jwb556/board1/README.txt

There are 54 SMD placements, with 26 unique parts
There are additionally (3) BOM line items that are TH and would be placed by hand

Assembly Cost Estimate
Quan	Price/Board
3	193
10	75.90
25	33.72
50	19.56
100	12.52
500	6.92
750	6.45
