jwb556/board1/bom/bom.xlsx

Id | Designator | Package | Quantity | Designation | Supplier and ref | Price | Quantity | Total
1 | ,,, | 1940-04-01 | 4 | 1940-04-01
2 | C1,C3,C5,C10,C12,C16 | C_0805_HandSoldering | 6 | 10uF | 399-8013-1-ND | 0.29 | 6 | 1.74
3 | C2,C4,C8,C9,C18 | C_0805_HandSoldering | 5 | 10u | 399-8013-1-ND | 0.29 | 5 | 1.45
4 | C6,C7 | C_0805_HandSoldering | 2 | 10n | 399-7995-1-ND | 0.24 | 2 | 0.48
5 | C11,C19,C20 | C_0805_HandSoldering | 3 | 1u | 399-1284-1-ND | 0.12 | 3 | 0.36
6 | C13,C14,C15,C17 | C_0805_HandSoldering | 4 | .1uF | 399-1167-1-ND | 0.11 | 4 | 0.44
7 | P1 | CONN_MOLEX_.1IN_2x5 | 1 | CONN_01X10 | WM9219-ND | 1.62 | 1 | 1.62
8 | R1 | R_0805_HandSoldering | 1 | 2.2k | 311-2.20KCRCT-ND | 0.1 | 1 | 0.1
9 | R2,R3 | R_0805_HandSoldering | 2 | 16k | P16.0KCCT-ND | 0.1 | 2 | 0.2
10 | R4,R5,R6,R7,R14 | R_0805_HandSoldering | 5 | 100k | P100KCDKR-ND | 0.1 | 5 | 0.5
11 | R8,R9 | R_0805_HandSoldering | 2 | 470 | 311-470ARCT-ND | 0.1 | 2 | 0.2
12 | R10,R11 | R_0805_HandSoldering | 2 | 1M | P1.00MCCT-ND | 0.1 | 2 | 0.2
13 | R12,R13 | R_0805_HandSoldering | 2 | 500 | RNCP0805FTD499RCT-ND | 0.1 | 2 | 0.2
14 | U1 | 781710002 | 1 | ConnP2 | WM4459CT-ND | 0.58 | 1 | 0.58
15 | U2 | CMA-4544PF-W | 1 | CMA-4544PF-W | 102-1721-ND | 0.96 | 1 | 0.96
16 | U3 | SOIC-8-N | 1 | MAX1659ESA | MAX1659ESA+-ND | 5.73 | 1 | 5.73
17 | U4 | SOIC-8-N | 1 | LT1881 | LT1881CS8#PBF-ND | 5.78 | 1 | 5.78
18 | U5 | SOT-23 | 1 | APE8865N-33-HF-3 | AS1360-50-TCT-ND | 1.41 | 1 | 1.41
19 | U6 | SOIC-8-N | 1 | LT1178 | LT1178S8#PBF-ND | 7.04 | 1 | 7.04
20 | U7 | ASFL1 | 1 | ASFL1-4.00MHZ-L-T | 535-9271-1-ND | 1.77 | 1 | 1.77
21 | U8 | SOT-23-6 | 1 | MAX1721 | MAX1721EUT+T-ND | 0.77 | 1 | 0.77
22 | D1,D2 | LED_0805 | 2 | LED | 160-1423-1-ND | 0.29 | 2 | 0.58
23 | W1,W2,W3,W4,W5,W6,W7,W8 | TESTPOINT-TH-KEYSTONE5118 | 8 | TEST_1P | 36-5118-ND | 0.37 | 8 | 2.96
24 | L1 | R_0805 | 1 | L_Small | 732-3433-1-ND | 0.92 | 1 | 0.92
25 | U9 | SOIC28-75 | 1 | dsPIC33EP32MC202-I | DSPIC33EP32MC202-I/SS-ND | 1.89 | 1 | 1.89
26 | C21,C22,C23,C24 | C_0805_HandSoldering | 4 | 2.2u | 399-1295-1-ND | 0.17 | 4 | 0.68
27 | U10 | 528921495 | 1 | CONNx14 | WM8835CT-ND (http://www.digikey.com/product-detail/en/molex-connector-corporation/52892-1495/52892-1495-ND/1060264) | 2.29 | 1 | 2.29
28 | R15,R16 | R_0805_HandSoldering | 2 | 12 | 311-12ARCT-ND | 0.1 | 2 | 0.2
29 | U11 | JST-SM02B-SRSS-TB | 1 | ConnP2 | 455-1802-1-ND | 0.44 | 1 | 0.44
30 | RV1 | POT-TC33X-2-103E | 1 | 10k | TC33X-103ECT-ND | 0.27 | 1 | 0.27
 |  |  |  |  |  |  | TOTAL | 41.76
) |  |  |  |  |  |  | 64
