jwb556/board1/enclosure/main_assembly.FCStd

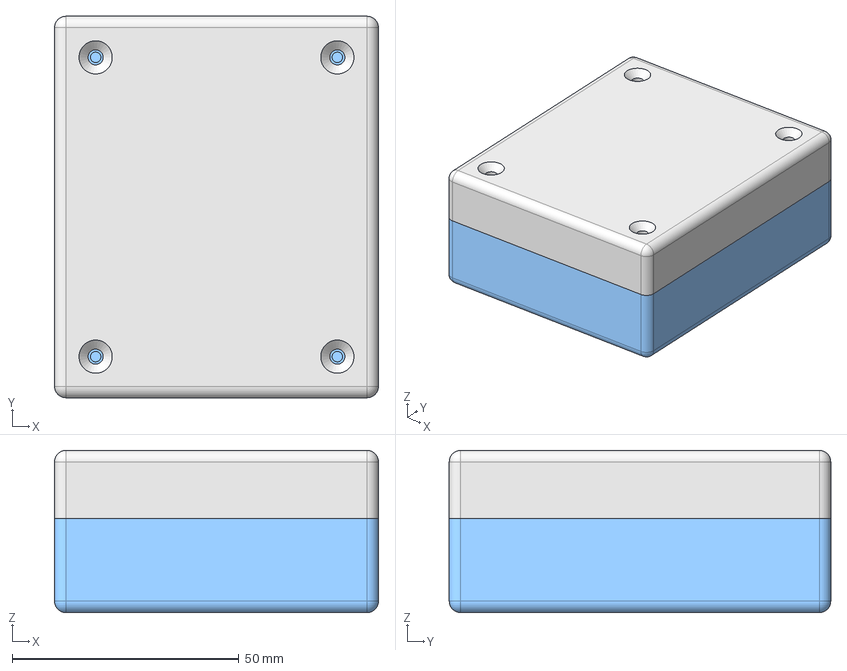
[picture p1: CAD file, 2016-06-01]
enclosure/main_assembly.FCStd
71.5 x 84.2 x 35.8 mm
