jwb556/board1/enclosure/main_bottom.FCStd

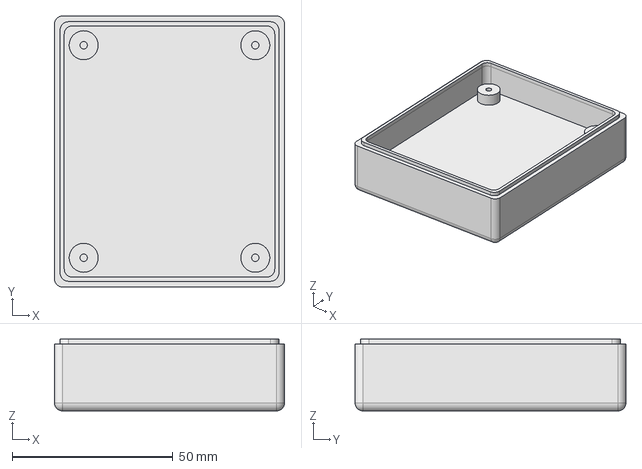
[picture p2: CAD file, 2016-06-01]
enclosure/main_bottom.FCStd
71.5 x 84.2 x 22.3 mm
