jwb556/board1/enclosure/main_top.step

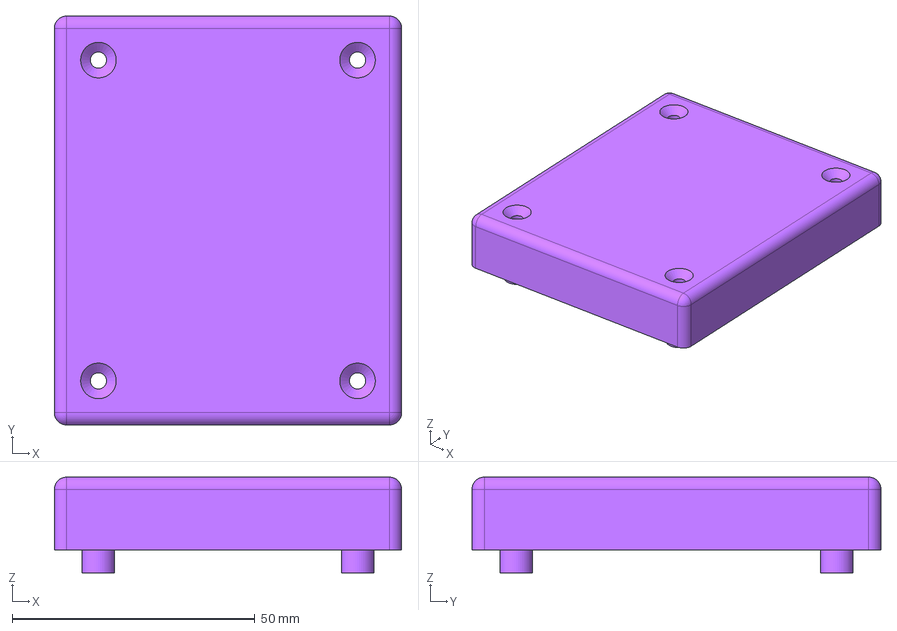
[picture p3: CAD file, 2016-06-01]
enclosure/main_top.step
71.5 x 84.2 x 19.7 mm
