jwb556/board1/enclosure/mock_board.FCStd

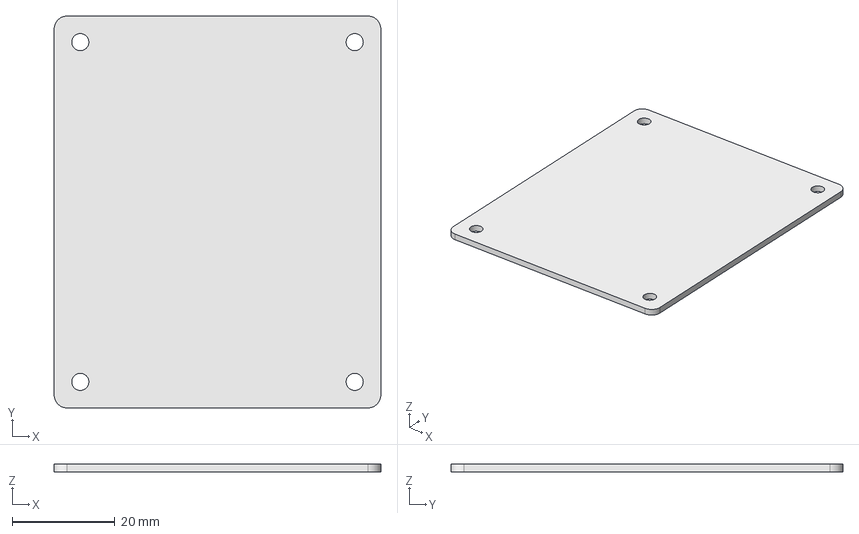
[picture p4: CAD file, 2016-06-01]
enclosure/mock_board.FCStd
63.5 x 76.2 x 1.57 mm
