jwb556/board1/jlibs/3DModels/mic.stp

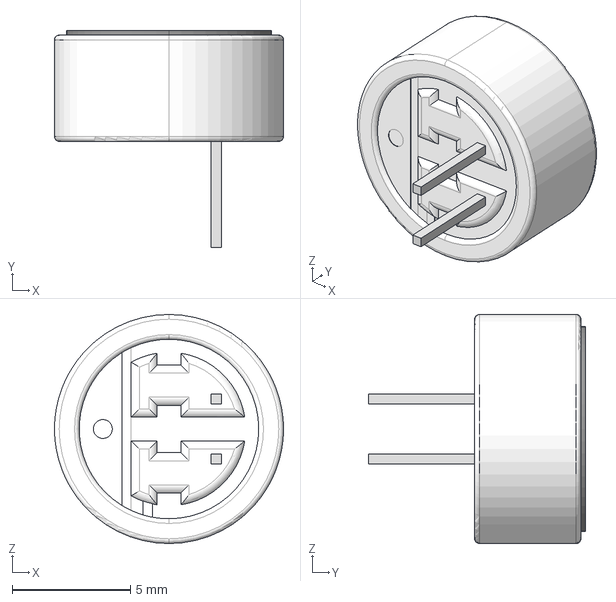
[picture p5: CAD file, 2016-06-01]
jlibs/3DModels/mic.stp
9.70 x 9.20 x 9.70 mm
