jwb556/board1/jlibs/3DModels/TC-33X-2.step

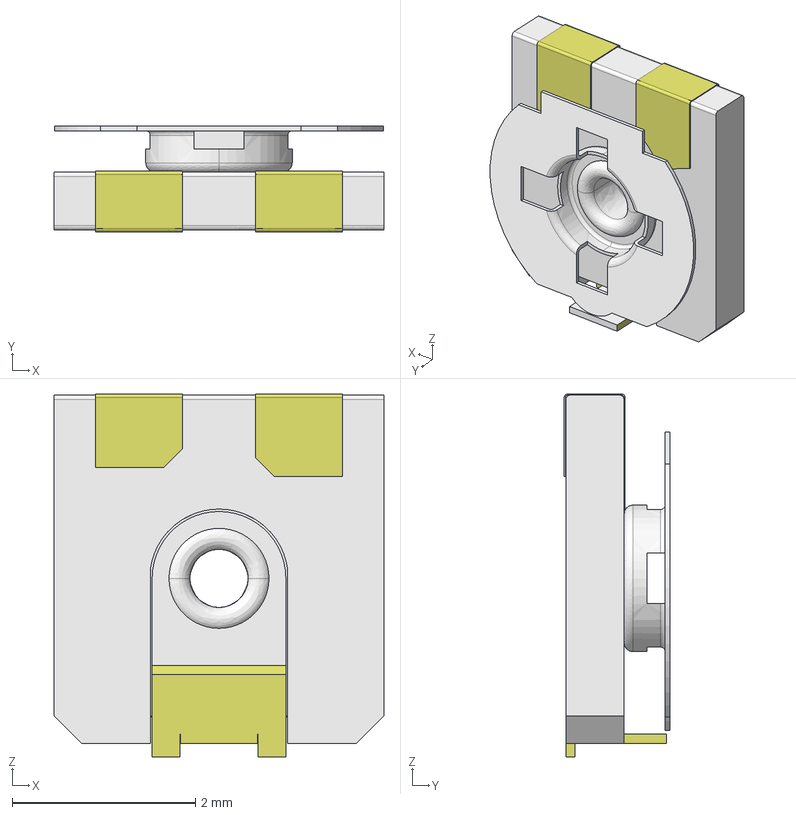
[picture p6: CAD file, 2016-06-01]
jlibs/3DModels/TC-33X-2.step
3.60 x 1.15 x 3.96 mm
