jwb556/board1/jlibs/3DModels/TP-5118.step

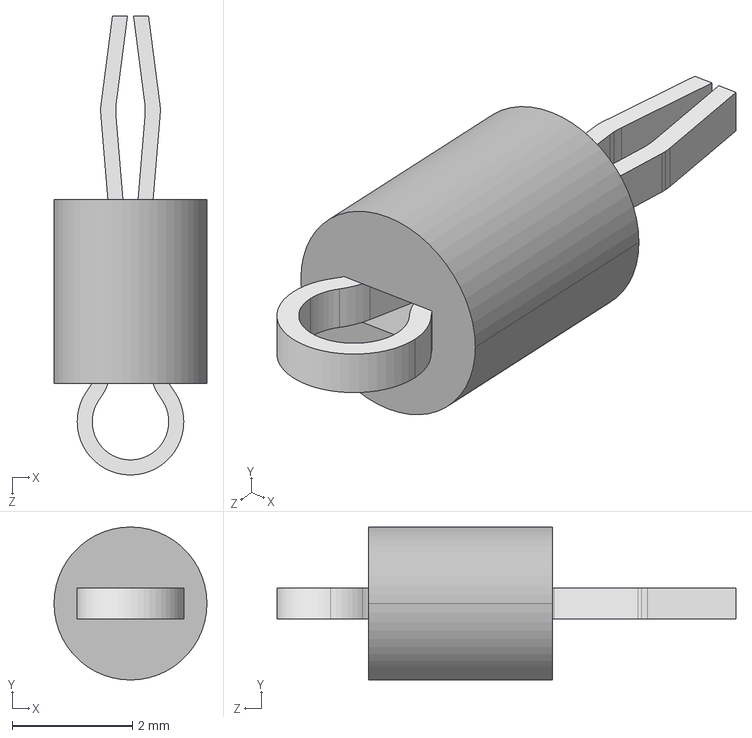
[picture p7: CAD file, 2016-06-01]
jlibs/3DModels/TP-5118.step
2.54 x 2.54 x 7.62 mm
User Library-Test Point Keystone - 5118 GREY_1
User Library-Test Point Keystone - 5118 GREY_2
