jwb556/board1/enclosure/enclosuretop.stl

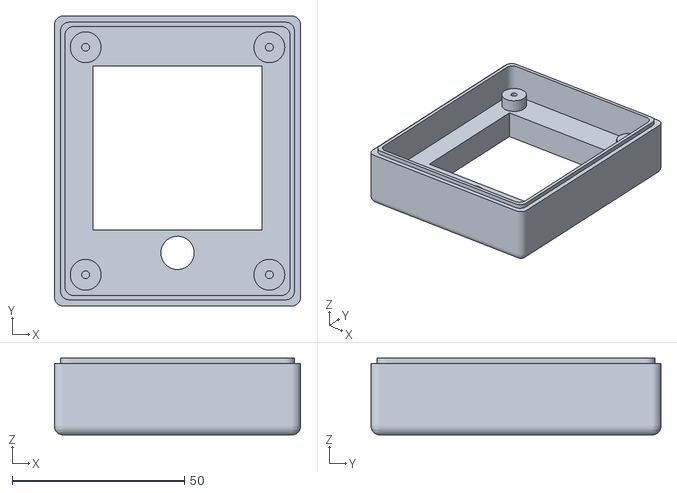
[picture p8: CAD file, 2016-06-01]
enclosure/enclosuretop.stl
71.5 x 84.2 x 22.3
