jwb556/board1/enclosure/pcb_mic.step

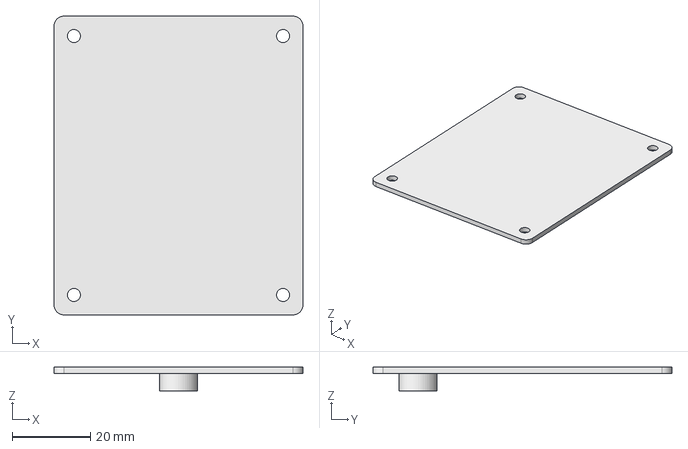
[picture p9: CAD file, 2016-06-01]
enclosure/pcb_mic.step
63.5 x 76.2 x 6.07 mm
