jwb556/board1/jlibs/3DModels/SOIC28.step

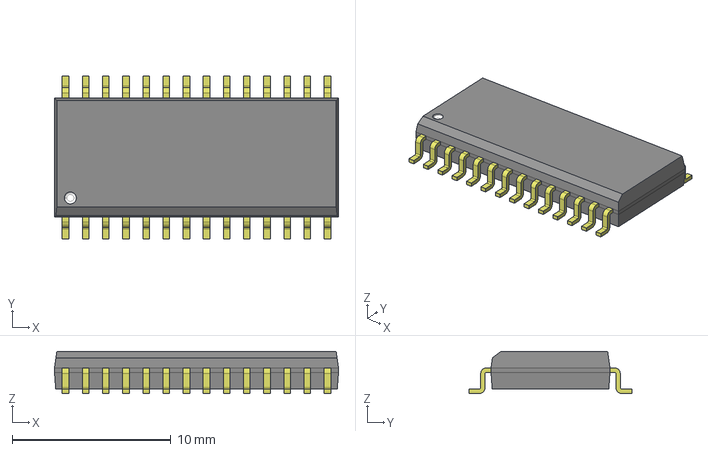
[picture p10: CAD file, 2016-06-01]
jlibs/3DModels/SOIC28.step
17.9 x 10.3 x 2.65 mm
