jwb556/board1/jlibs/3DModels/ASFL1.step

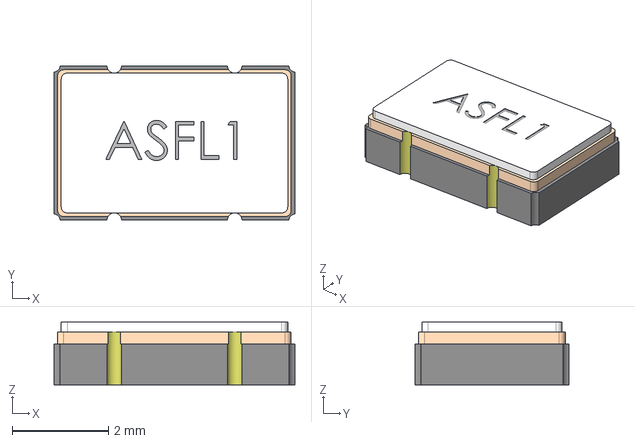
[picture p11: CAD file, 2016-06-01]
jlibs/3DModels/ASFL1.step
5.00 x 3.20 x 1.30 mm
