jwb556/board1/jlibs/3DModels/702461001.step

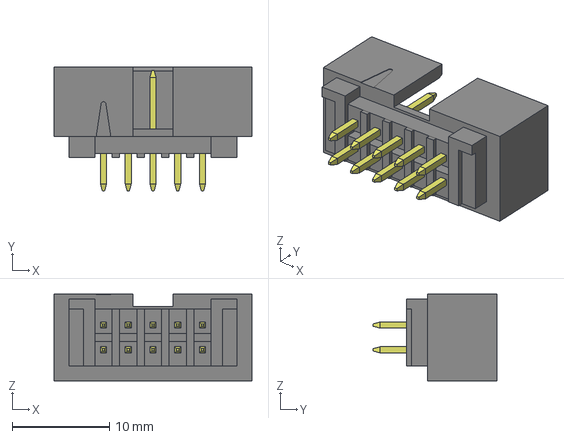
[picture p12: CAD file, 2016-06-01]
jlibs/3DModels/702461001.step
20.3 x 12.7 x 8.89 mm
