jwb556/board1/jlibs/3DModels/781710002.step

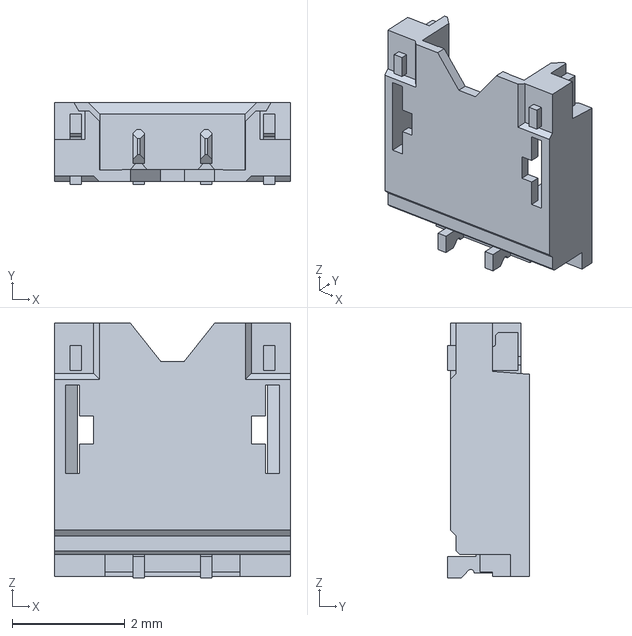
[picture p13: CAD file, 2016-06-01]
jlibs/3DModels/781710002.step
4.20 x 1.45 x 4.53 mm
