jwb556/board1/jlibs/3DModels/528921495.step

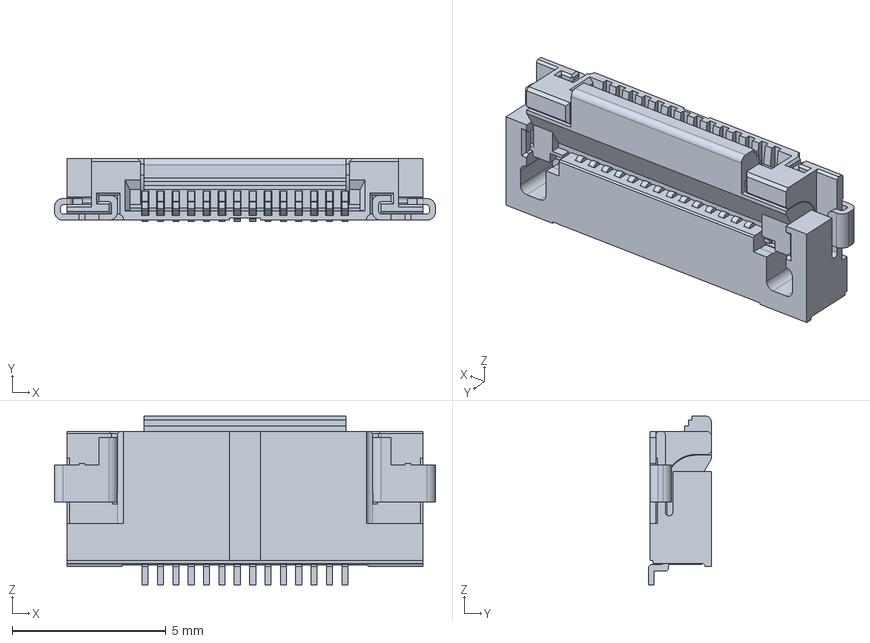
[picture p14: CAD file, 2016-06-01]
jlibs/3DModels/528921495.step
12.4 x 2.04 x 5.50 mm
