jwb556/board1/(list of files, cad)

Other CAD files:
enclosure/enclosurebottom.stl
jlibs/3DModels/User Library-SOIC28-300.step
jlibs/3DModels/SOIC28-300.STEP
enclosure/main_top.FCStd
