jwb556/board1/docs/schematic.pdf

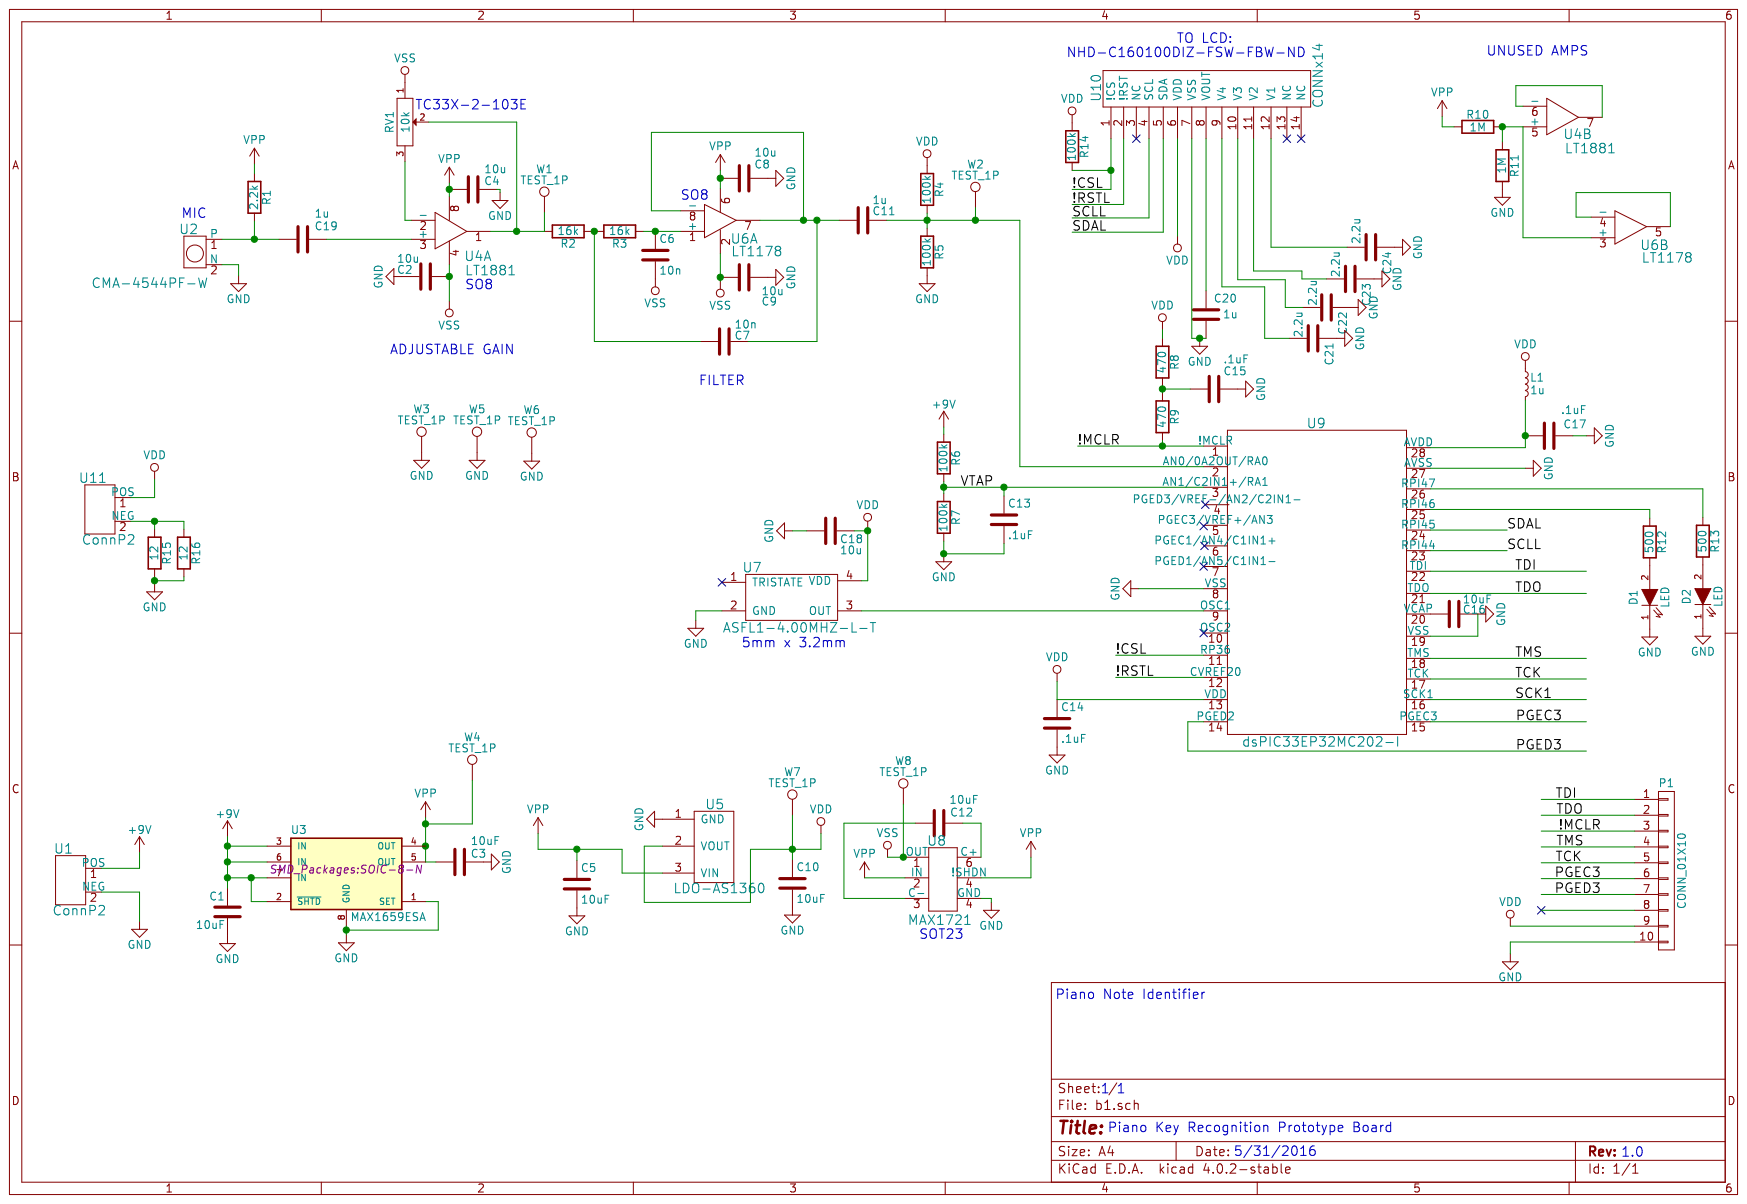
[picture p15: page 1]
