jwb556/board1/b1.kicad_pcb

## KiCad design b1.kicad_pcb (2016-06-01)

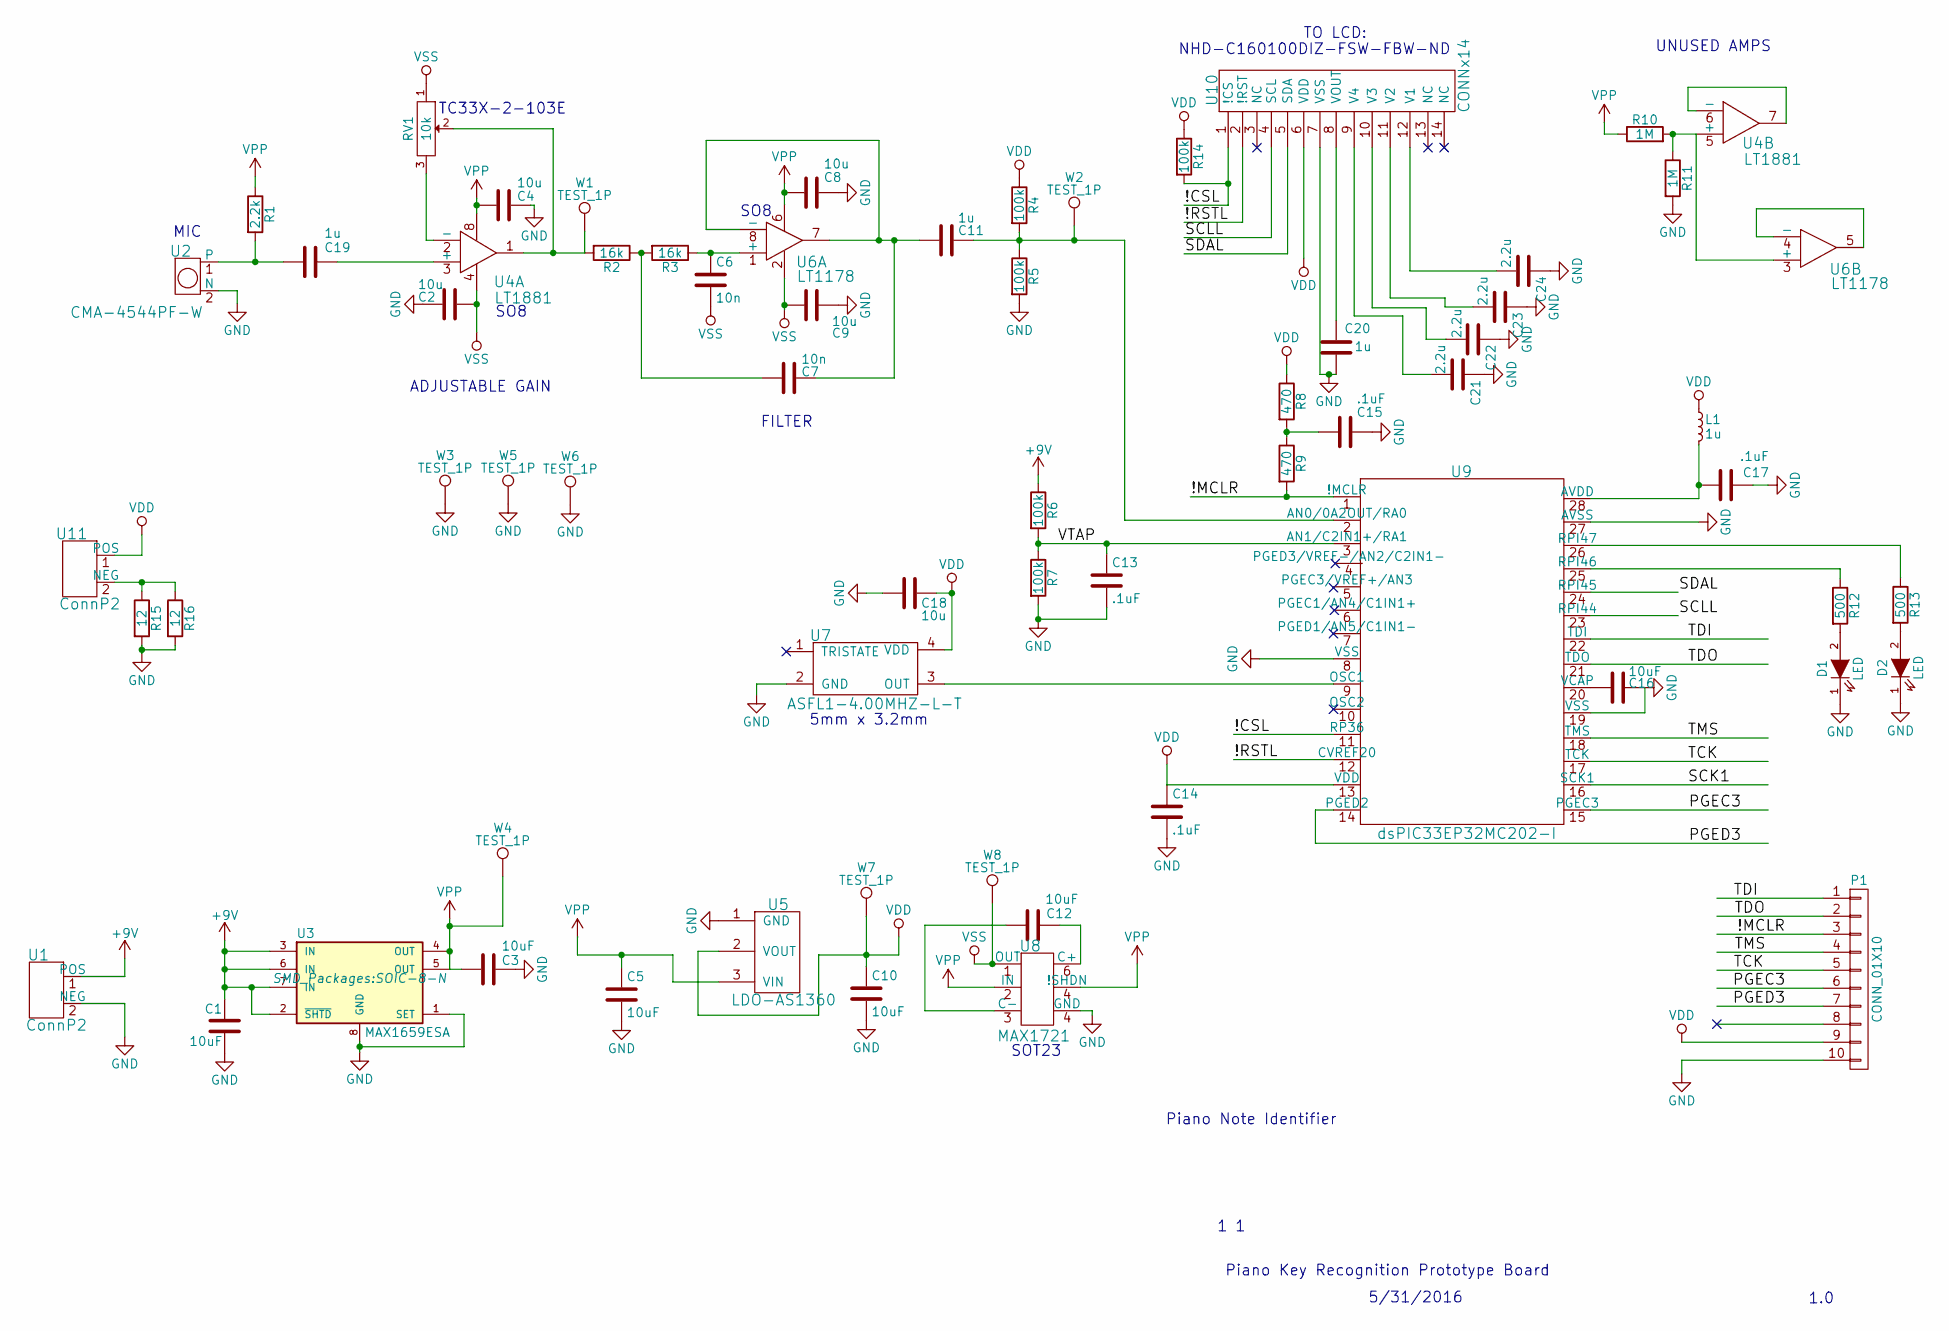
[picture p16: schematic b1.sch]

Parts:
C1, C3, C5, C10, C12, C16: 10uF; C_0805_HandSoldering
C2, C4, C8, C9, C18: 10u; C_0805_HandSoldering
C6, C7: 10n; C_0805_HandSoldering
C11, C19, C20: 1u; C_0805_HandSoldering
C13, C14, C15, C17: .1uF; C_0805_HandSoldering
C21, C22, C23, C24: 2.2u; C_0805_HandSoldering
D1, D2: LED; LED_0805
L1: 1u; R_0805
P1: CONN_01X10; CONN_MOLEX_.1IN_2x5
R1: 2.2k; R_0805_HandSoldering
R2, R3: 16k; R_0805_HandSoldering
R4, R5, R6, R7, R14: 100k; R_0805_HandSoldering
R8, R9: 470; R_0805_HandSoldering
R10, R11: 1M; R_0805_HandSoldering
R12, R13: 500; R_0805_HandSoldering
R15, R16: 12; R_0805_HandSoldering
RV1: 10k; POT-TC33X-2-103E
U1: ConnP2; 781710002
U2: CMA-4544PF-W
U3: MAX1659ESA; SOIC-8-N
U4: LT1881; SOIC-8-N
U5: LDO-AS1360; SOT-23
U6: LT1178; SOIC-8-N
U7: ASFL1-4.00MHZ-L-T; ASFL1
U8: MAX1721; SOT-23-6
U9: dsPIC33EP32MC202-I; SOIC28-75
U10: CONNx14; 545482671
U11: ConnP2; JST-SM02B-SRSS-TB
W1, W2, W3, W4, W5, W6, W7, W8: TEST_1P; TESTPOINT-TH-KEYSTONE5118

Connections:
+9V: C1.1, R6.1, U1.1 (POS), U3.2 (~SHTD), U3.3 (IN), U3.6 (IN), U3.7 (IN)
/!CSL: R14.2, U9.11 (RP36), U10.1 (!CS)
/!MCLR: P1.3, R9.2, U9.1 (!MCLR)
/!RSTL: U9.12 (CVREF20), U10.2 (!RST)
/PGEC3: P1.6, U9.15 (PGEC3)
/PGED3: P1.7, U9.14 (PGED2)
/SCLL: U9.23 (RPI44), U10.4 (SCL)
/SDAL: U9.24 (RPI45), U10.5 (SDA)
/TCK: P1.5, U9.17 (TCK)
/TDI: P1.1, U9.22 (TDI)
/TDO: P1.2, U9.21 (TDO)
/TMS: P1.4, U9.18 (TMS)
/VTAP: C13.1, R6.2, R7.1, U9.3 (AN1/C2IN1+/RA1)
unnamed: C6.1, R3.1, U6.1 (+)
unnamed: C7.2, R2.1, R3.2
unnamed: C11.1, R4.2, R5.1, U9.2 (AN0/0A2OUT/RA0), W2.1
unnamed: C7.1, C11.2, U6.7, U6.8 (-)
unnamed: C12.1, U8.6 (C+)
unnamed: C12.2, U8.3 (C-)
unnamed: C15.2, R8.2, R9.1
unnamed: C16.2, U9.20 (VCAP)
unnamed: C17.2, L1.2, U9.28 (AVDD)
unnamed: C19.1, U4.3 (+)
unnamed: C19.2, R1.2, U2.1
unnamed: C20.2, U10.8 (VOUT)
unnamed: C21.2, U10.9 (V4)
unnamed: C22.2, U10.10 (V3)
unnamed: C23.2, U10.11 (V2)
unnamed: C24.2, U10.12 (V1)
unnamed: D1.2 (A), R12.2
unnamed: D2.2 (A), R13.2
unnamed: R2.2, RV1.2, U4.1, W1.1
unnamed: R10.2, R11.1, U4.5 (+), U6.3 (+)
unnamed: R12.1, U9.25 (RPI46)
unnamed: R13.1, U9.26 (RPI47)
unnamed: R15.1, R16.1, U11.2 (NEG)
unnamed: RV1.3, U4.2 (-)
unnamed: U4.6 (-), U4.7
unnamed: U6.4 (-), U6.5
unnamed: U7.3 (OUT), U9.9 (OSC1)
VDD: C10.1, C14.1, C18.1, L1.1, P1.9, R4.1, R8.1, R14.1, U5.2 (VOUT), U7.4 (VDD), U9.13 (VDD), U10.6 (VDD), U11.1 (POS), W7.1
VSS: C2.1, C6.2, C9.2, RV1.1, U4.4, U6.2, U8.1 (OUT), W8.1

Notes on the sheet:
Piano Note Identifier
Piano Key Recognition Prototype Board
UNUSED AMPS
FILTER
ADJUSTABLE GAIN
MIC
5mm x 3.2mm
SOT23
SO8
SO8
TO LCD:
NHD-C160100DIZ-FSW-FBW-ND
1.0
5/31/2016
TC33X-2-103E

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
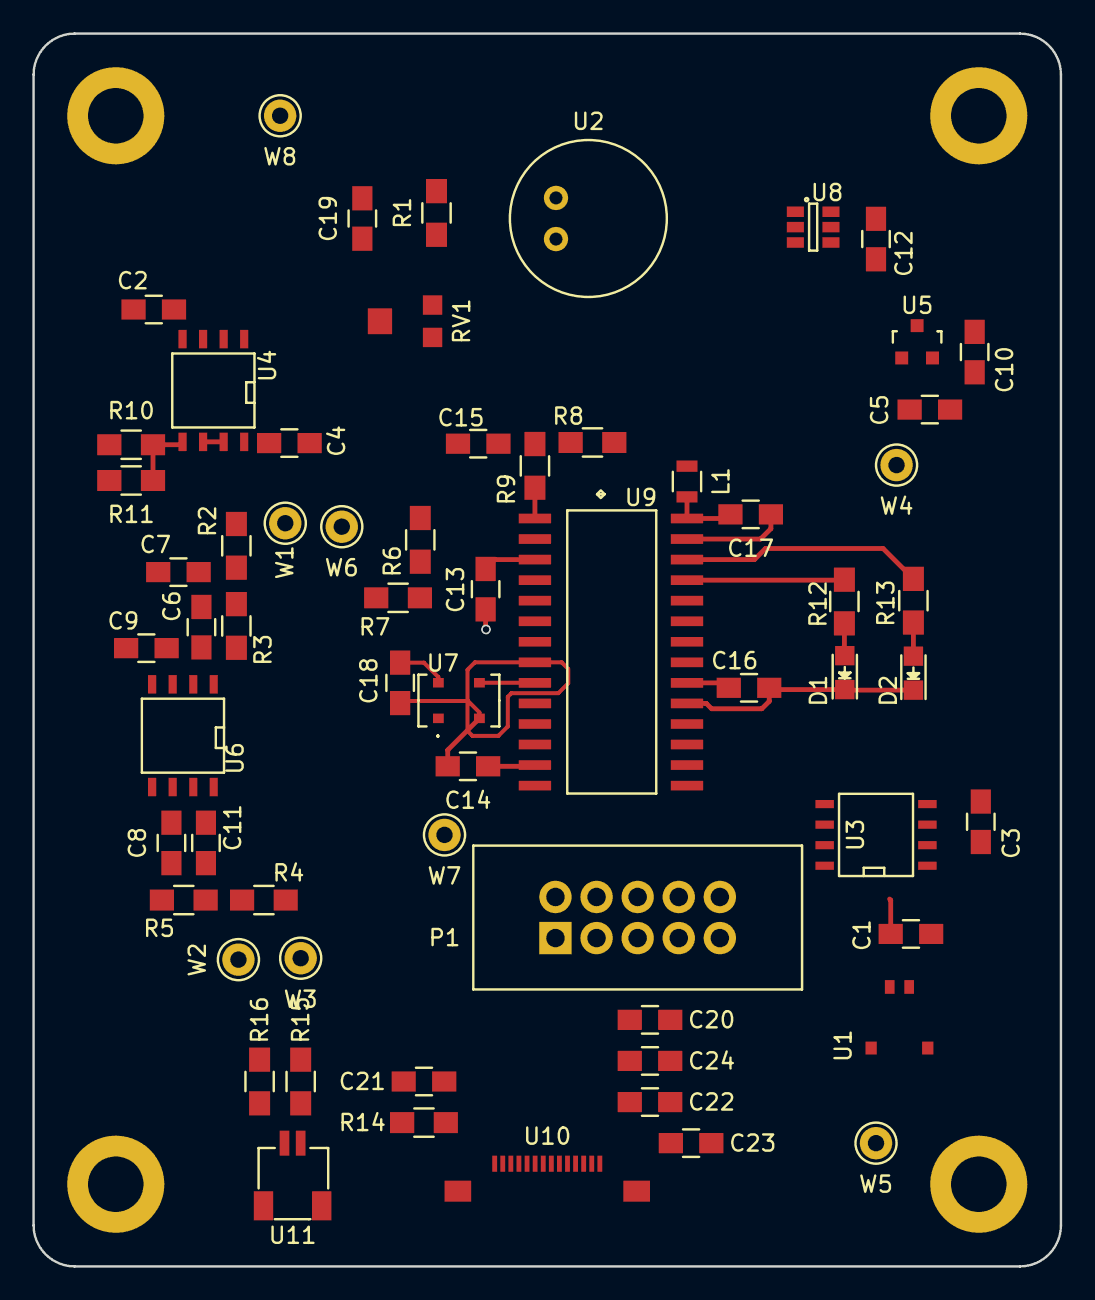
[picture p17: board b1.kicad_pcb from above]

Board: 2 copper layers, 63.5 x 76.2 mm, 64 parts (0 on the bottom side), 44 nets.
